m-pardhiv/SeaMesh/firmware/seamesh_mesh/seamesh_mesh.ino

// SeaMesh mesh node - ESP32 + Ra-02 (SX1278, 433 MHz)
//
// The same firmware runs on every boat. Only the settings block changes.
//  - Boat WITHOUT signal: broadcasts its own position/SOS and relays others.
//  - Boat WITH signal (joined to the phone hotspot = "cellular"): uploads
//    every packet it hears to the dashboard and ACKs SOS messages.
//    The React dashboard reads it as JSON from http://<gateway IP>/data
//
// Packet (text, ~45 bytes):
//   type,origin,msgId,lat,lon,time,hop,trigger,via
//   type: P = position, S = SOS, A = ack     via = last boat that transmitted it
//
// Serial commands (115200): sos, cancel, pos, offline, online, status

#include <SPI.h>
#include <LoRa.h>
#include <WiFi.h>
#include <WebServer.h>

// ================= Per-boat settings =================
#define BOAT_ID   "A"          // A, B, C ... (letters/numbers only)
#define WIFI_SSID ""           // phone hotspot = this boat's "cellular". "" = no signal
#define WIFI_PASS ""
#define BASE_LAT  0            // simulated GPS start position; 0 = pick a sea
#define BASE_LON  0            // position off Kochi from BOAT_ID (see initPosition)
// =====================================================

// Radio - minimum power, because there is no antenna
#define FREQ      433E6
#define TX_POWER  2
#define SYNC_WORD 0x5E
#define MAX_HOPS  4

// Ra-02 -> ESP32 wiring
#define PIN_SS   5
#define PIN_RST  14
#define PIN_DIO0 26
#define PIN_SCK  18
#define PIN_MISO 19
#define PIN_MOSI 23

// Sensors are optional: with nothing wired, both pins are held HIGH by the
// internal pull-ups and read as "no emergency". A missing sensor is never a fault.
#define PIN_SOS_BTN 27         // push button to GND
#define PIN_WATER   33         // bare wire; second bare wire to GND. Water bridging
                               // them pulls the pin LOW (use salty water for the demo)
#define WATER_WET_MS 2000      // must stay wet this long before it counts
#define LED_PIN     2

#define POS_INTERVAL    20000  // routine position update
#define SOS_INTERVAL    4000   // SOS repeat
#define SOS_MAX_REPEATS 15

struct Packet {
  char type;
  String origin;
  uint16_t msgId;
  float lat, lon;
  uint32_t t;
  uint8_t hop;
  String trig;
  String via;
};

// ---------- state ----------
uint16_t nextMsgId = 1;
float curLat, curLon;
unsigned long lastPos = 0;
bool forceOffline = false;
bool serverStarted = false;

bool sosActive = false;
String sosTrig = "";
int sosRepeats = 0;
unsigned long lastSos = 0;

unsigned long wetSince = 0;
bool lastBtn = HIGH;

// duplicate filter
#define SEEN_SIZE 40
String seen[SEEN_SIZE];
int seenPos = 0;

// relay queue
#define QUEUE_SIZE 6
struct Queued { bool used; Packet p; unsigned long due; };
Queued queue[QUEUE_SIZE];

// dashboard (only used when this boat is online)
#define TRAIL_LEN 10
struct BoatInfo {
  String id; float lat, lon; char type; int hops; String via;
  uint16_t msgId; unsigned long seenAt; int rssi; String trig;
  float trailLat[TRAIL_LEN], trailLon[TRAIL_LEN]; int trailCount;
};
#define MAX_BOATS 8
BoatInfo boats[MAX_BOATS];
int boatCount = 0;
#define MAX_EVENTS 12
String events[MAX_EVENTS];
int eventCount = 0;

WebServer server(80);

// ---------- helpers ----------
void blink() {
  digitalWrite(LED_PIN, HIGH);
  delay(30);
  digitalWrite(LED_PIN, sosActive ? HIGH : LOW);
}

bool online() {
  return strlen(WIFI_SSID) > 0 && !forceOffline && WiFi.status() == WL_CONNECTED;
}

uint32_t uptimeSec() { return millis() / 1000; }

bool isSafeField(const String& s) {
  if (s.length() == 0 || s.length() > 8) return false;
  for (unsigned int i = 0; i < s.length(); i++) {
    if (!isAlphaNumeric(s[i]) && s[i] != '-') return false;
  }
  return true;
}

String encode(const Packet& p) {
  return String(p.type) + "," + p.origin + "," + String(p.msgId) + "," +
         String(p.lat, 5) + "," + String(p.lon, 5) + "," + String(p.t) + "," +
         String(p.hop) + "," + p.trig + "," + p.via;
}

bool decode(const String& s, Packet& p) {
  String f[9];
  int idx = 0, start = 0;
  for (unsigned int i = 0; i <= s.length() && idx < 9; i++) {
    if (i == s.length() || s[i] == ',') {
      f[idx++] = s.substring(start, i);
      start = i + 1;
    }
  }
  if (idx != 9 || f[0].length() != 1) return false;
  p.type = f[0][0];
  if (p.type != 'P' && p.type != 'S' && p.type != 'A') return false;
  if (!isSafeField(f[1]) || !isSafeField(f[7]) || !isSafeField(f[8])) return false;
  p.origin = f[1];
  p.msgId = f[2].toInt();
  p.lat = f[3].toFloat();
  p.lon = f[4].toFloat();
  p.t = f[5].toInt();
  p.hop = f[6].toInt();
  p.trig = f[7];
  p.via = f[8];
  return true;
}

String keyOf(const Packet& p) {
  return String(p.type) + p.origin + ":" + String(p.msgId);
}

bool alreadySeen(const String& key) {
  for (int i = 0; i < SEEN_SIZE; i++) if (seen[i] == key) return true;
  return false;
}

void remember(const String& key) {
  seen[seenPos] = key;
  seenPos = (seenPos + 1) % SEEN_SIZE;
}

void addEvent(const String& e) {
  String line = String(uptimeSec()) + "s  " + e;
  Serial.println("EVENT " + line);
  if (eventCount < MAX_EVENTS) {
    events[eventCount++] = line;
  } else {
    for (int i = 1; i < MAX_EVENTS; i++) events[i - 1] = events[i];
    events[MAX_EVENTS - 1] = line;
  }
}

// ---------- radio ----------
byte readChipVersion() {
  pinMode(PIN_RST, OUTPUT);
  digitalWrite(PIN_RST, LOW);
  delay(10);
  digitalWrite(PIN_RST, HIGH);
  delay(10);
  pinMode(PIN_SS, OUTPUT);
  digitalWrite(PIN_SS, HIGH);
  SPI.beginTransaction(SPISettings(1000000, MSBFIRST, SPI_MODE0));
  digitalWrite(PIN_SS, LOW);
  SPI.transfer(0x42 & 0x7F);
  byte v = SPI.transfer(0x00);
  digitalWrite(PIN_SS, HIGH);
  SPI.endTransaction();
  return v;
}

void transmit(Packet p) {
  p.via = BOAT_ID;
  String s = encode(p);
  LoRa.beginPacket();
  LoRa.print(s);
  LoRa.endPacket();
  Serial.println("TX    " + s);
  blink();
}

void enqueue(const Packet& p) {
  // SOS and ACKs go out almost immediately, routine updates wait a little
  // (random jitter so two relays don't transmit on top of each other)
  unsigned long delayMs = (p.type == 'P') ? random(200, 800) : random(20, 80);
  for (int i = 0; i < QUEUE_SIZE; i++) {
    if (!queue[i].used) {
      queue[i] = { true, p, millis() + delayMs };
      return;
    }
  }
  Serial.println("WARN  relay queue full, dropped " + keyOf(p));
}

void processQueue() {
  int pick = -1;
  for (int i = 0; i < QUEUE_SIZE; i++) {
    if (!queue[i].used || millis() < queue[i].due) continue;
    if (pick < 0 || (queue[i].p.type != 'P' && queue[pick].p.type == 'P')) pick = i;
  }
  if (pick >= 0) {
    queue[pick].used = false;
    transmit(queue[pick].p);
  }
}

// ---------- dashboard ----------
// The dashboard keeps the last packet heard from every boat, so a boat that
// goes silent stays on the map at its last known position.
void upload(const Packet& p, int rssi) {
  int i = 0;
  while (i < boatCount && boats[i].id != p.origin) i++;
  if (i == boatCount) {
    if (boatCount == MAX_BOATS) return;
    boats[i] = BoatInfo();
    boats[i].id = p.origin;
    boats[i].type = 'P';
    boatCount++;
  }
  BoatInfo& b = boats[i];

  // an SOS stays on the map as SOS until that boat's SOS is over
  bool sosSticky = p.type == 'P' && b.type == 'S' && millis() - b.seenAt < 60000;
  b.type = sosSticky ? 'S' : p.type;
  if (!sosSticky) b.trig = p.trig;
  b.lat = p.lat;
  b.lon = p.lon;
  b.hops = p.hop;
  b.via = p.via;
  b.msgId = p.msgId;
  b.seenAt = millis();
  b.rssi = rssi;

  if (b.trailCount == TRAIL_LEN) {
    for (int k = 1; k < TRAIL_LEN; k++) {
      b.trailLat[k - 1] = b.trailLat[k];
      b.trailLon[k - 1] = b.trailLon[k];
    }
    b.trailCount--;
  }
  b.trailLat[b.trailCount] = p.lat;
  b.trailLon[b.trailCount] = p.lon;
  b.trailCount++;

  String how = (p.origin == BOAT_ID) ? "own position"
             : (p.hop == 0 ? "direct" : String(p.hop) + " relay hop(s), last via " + p.via);
  addEvent(String(p.type == 'S' ? "SOS" : "Position") + " from boat " + p.origin +
           " (" + how + ")" + (rssi != 0 ? ", RSSI " + String(rssi) : ""));
}

#define STALE_SEC 60   // no contact for this long = shown as "last known"

// JSON API for the React dashboard (CORS open so it can run on any origin)
void handleData() {
  server.sendHeader("Access-Control-Allow-Origin", "*");
  server.sendHeader("Cache-Control", "no-store");
  String j = "{\"gw\":\"" BOAT_ID "\",\"online\":" + String(online() ? "true" : "false") +
             ",\"uptime\":" + String(uptimeSec()) + ",\"boats\":[";
  for (int i = 0; i < boatCount; i++) {
    BoatInfo& b = boats[i];
    unsigned long age = (millis() - b.seenAt) / 1000;
    if (i) j += ",";
    j += "{\"id\":\"" + b.id + "\",\"lat\":" + String(b.lat, 5) + ",\"lon\":" + String(b.lon, 5) +
         ",\"type\":\"" + String(b.type) + "\",\"hops\":" + String(b.hops) + ",\"via\":\"" + b.via +
         "\",\"msg\":" + String(b.msgId) + ",\"age\":" + String(age) +
         ",\"stale\":" + String(age > STALE_SEC ? "true" : "false") +
         ",\"rssi\":" + String(b.rssi) + ",\"trig\":\"" + b.trig + "\",\"trail\":[";
    for (int k = 0; k < b.trailCount; k++) {
      if (k) j += ",";
      j += "[" + String(b.trailLat[k], 5) + "," + String(b.trailLon[k], 5) + "]";
    }
    j += "]}";
  }
  j += "],\"events\":[";
  for (int i = 0; i < eventCount; i++) {
    if (i) j += ",";
    j += "\"" + events[i] + "\"";
  }
  j += "]}";
  server.send(200, "application/json", j);
}

// ---------- own messages ----------
// Simulated GPS: every boat starts out at sea off Kochi, inside or outside
// the ~20 km cellular coverage around Kochi.
void initPosition() {
  if (BASE_LAT != 0) { curLat = BASE_LAT; curLon = BASE_LON; return; }
  switch (BOAT_ID[0]) {
    case 'A': curLat = 9.9500; curLon = 75.9500; break;   // ~32 km out, no signal
    case 'B': curLat = 9.9800; curLon = 76.1400; break;   // ~12 km out, in coverage
    case 'C': curLat = 9.9650; curLon = 76.0400; break;   // ~24 km out, between them
    default:  curLat = 9.9200 + random(0, 600) / 10000.0;
              curLon = 75.9800 + random(0, 1000) / 10000.0; break;
  }
}

Packet makeOwn(char type, const String& trig) {
  Packet p;
  p.type = type;
  p.origin = BOAT_ID;
  p.msgId = nextMsgId++;
  p.lat = curLat;
  p.lon = curLon;
  p.t = uptimeSec();
  p.hop = 0;
  p.trig = trig;
  p.via = BOAT_ID;
  return p;
}

void sendOwn(const Packet& p) {
  remember(keyOf(p));
  if (online()) {
    upload(p, 0);          // we have signal ourselves - straight to the dashboard
    if (p.type == 'S') sosActive = false;
  } else {
    transmit(p);
  }
}

// Each repeat is a new message id, so a repeat that follows a lost packet
// or a lost ACK is relayed and ACKed again instead of dropped as a duplicate.
void sendSos() {
  sosRepeats++;
  lastSos = millis();
  Serial.println("SOS   attempt " + String(sosRepeats) + "/" + String(SOS_MAX_REPEATS));
  sendOwn(makeOwn('S', sosTrig));
}

void triggerSos(const String& trig) {
  if (sosActive) return;
  sosActive = true;
  sosTrig = trig;
  sosRepeats = 0;
  digitalWrite(LED_PIN, HIGH);
  Serial.println("!!!   SOS triggered by " + trig);
  sendSos();
}

void cancelSos(const String& why) {
  if (!sosActive) return;
  sosActive = false;
  digitalWrite(LED_PIN, LOW);
  Serial.println("SOS   stopped: " + why);
}

// ---------- incoming ----------
void onPacket(Packet p, int rssi) {
  String key = keyOf(p);
  if (alreadySeen(key)) {
    Serial.println("DUP   " + key + " dropped");
    return;
  }
  remember(key);
  Serial.println("RX    " + encode(p) + "  RSSI " + String(rssi));

  // ACK for one of our own SOS messages
  if (p.type == 'A' && p.origin == BOAT_ID) {
    if (sosActive) cancelSos("ACK from shore via boat " + p.via + " - SOS delivered!");
    return;
  }
  if (p.origin == BOAT_ID) return;   // our own packet echoed back by a relay

  if (online() && p.type != 'A') {
    upload(p, rssi);
    if (p.type == 'S') {
      Packet ack = p;
      ack.type = 'A';
      ack.hop = 0;
      ack.trig = "ACK";
      remember(keyOf(ack));
      enqueue(ack);
    }
    return;
  }

  if (p.hop + 1 >= MAX_HOPS) {
    Serial.println("DROP  " + key + " hop limit reached");
    return;
  }
  p.hop++;
  Serial.println("RELAY " + key + " (hop " + String(p.hop) + ")");
  enqueue(p);
}

// ---------- inputs ----------
void checkInputs() {
  bool btn = digitalRead(PIN_SOS_BTN);
  if (btn == LOW && lastBtn == HIGH) {
    delay(30);
    if (digitalRead(PIN_SOS_BTN) == LOW) triggerSos("BTN");
  }
  lastBtn = btn;

  if (digitalRead(PIN_WATER) == LOW) {
    if (wetSince == 0) wetSince = millis();
    else if (millis() - wetSince > WATER_WET_MS) triggerSos("WATER");
  } else {
    wetSince = 0;
  }

  if (Serial.available()) {
    String cmd = Serial.readStringUntil('\n');
    cmd.trim();
    if (cmd == "sos") triggerSos("BTN");
    else if (cmd == "cancel") cancelSos("cancelled by user");
    else if (cmd == "pos") sendOwn(makeOwn('P', "-"));
    else if (cmd == "offline") { forceOffline = true; Serial.println("MODE  forced offline (no cellular)"); }
    else if (cmd == "online") { forceOffline = false; Serial.println("MODE  online allowed"); }
    else if (cmd == "status") {
      Serial.println("STAT  boat " BOAT_ID ", " + String(online() ? "ONLINE (gateway)" : "OFFLINE (relay)") +
                     ", SOS " + String(sosActive ? "active" : "off") +
                     (WiFi.status() == WL_CONNECTED ? ", IP " + WiFi.localIP().toString() : ""));
    }
  }
}

void setup() {
  Serial.begin(115200);
  delay(1000);
  pinMode(LED_PIN, OUTPUT);
  pinMode(PIN_SOS_BTN, INPUT_PULLUP);
  pinMode(PIN_WATER, INPUT_PULLUP);
  randomSeed(esp_random());
  initPosition();

  Serial.println();
  Serial.println("=== SeaMesh node " BOAT_ID " ===");

  SPI.begin(PIN_SCK, PIN_MISO, PIN_MOSI, PIN_SS);
  byte v = readChipVersion();
  Serial.println("Chip version: 0x" + String(v, HEX));
  if (v != 0x12) {
    Serial.println("[FAIL] Ra-02 not found - check wiring");
    while (1) { digitalWrite(LED_PIN, !digitalRead(LED_PIN)); delay(150); }
  }
  LoRa.setPins(PIN_SS, PIN_RST, PIN_DIO0);
  if (!LoRa.begin(FREQ)) {
    Serial.println("[FAIL] LoRa.begin() failed");
    while (1) { digitalWrite(LED_PIN, !digitalRead(LED_PIN)); delay(150); }
  }
  LoRa.setTxPower(TX_POWER);
  LoRa.setSyncWord(SYNC_WORD);
  LoRa.enableCrc();
  Serial.println("[OK] LoRa 433 MHz, TX power " + String(TX_POWER) + " dBm (no antenna mode)");

  Serial.println("[OK] Sensors optional: SOS button D27, water D33 (nothing wired = no alert)");

  if (strlen(WIFI_SSID) > 0) {
    WiFi.mode(WIFI_STA);
    WiFi.setAutoReconnect(true);
    WiFi.begin(WIFI_SSID, WIFI_PASS);
    Serial.println("[..] Joining hotspot '" WIFI_SSID "' (this boat's cellular link)");
  } else {
    WiFi.mode(WIFI_OFF);
    Serial.println("[--] No hotspot set - this boat has no signal, will relay over LoRa");
  }

  server.on("/", []() {
    server.sendHeader("Access-Control-Allow-Origin", "*");
    server.send(200, "application/json", "{\"service\":\"SeaMesh gateway\",\"boat\":\"" BOAT_ID "\",\"data\":\"/data\"}");
  });
  server.on("/data", handleData);
  Serial.println("Commands: sos, cancel, pos, offline, online, status");
  Serial.println("--------------------------");
}

void loop() {
  // start the dashboard once the hotspot connection is up
  if (!serverStarted && WiFi.status() == WL_CONNECTED) {
    server.begin();
    serverStarted = true;
    Serial.println("[OK] Online - dashboard data at http://" + WiFi.localIP().toString() + "/data");
    addEvent("Gateway boat " BOAT_ID " online");
  }
  if (serverStarted) server.handleClient();

  int size = LoRa.parsePacket();
  if (size) {
    String s;
    while (LoRa.available()) s += (char)LoRa.read();
    Packet p;
    if (decode(s, p)) onPacket(p, LoRa.packetRssi());
    else Serial.println("BAD   ignored: " + s);
    blink();
  }

  checkInputs();
  processQueue();

  if (sosActive && millis() - lastSos > SOS_INTERVAL) {
    if (sosRepeats >= SOS_MAX_REPEATS) cancelSos("no ACK after " + String(SOS_MAX_REPEATS) + " tries");
    else sendSos();
  }

  if (!sosActive && millis() - lastPos > POS_INTERVAL) {
    lastPos = millis();
    curLat += random(-20, 21) / 100000.0;   // simulated drift
    curLon += random(-20, 21) / 100000.0;
    sendOwn(makeOwn('P', "-"));
  }
}
