m-pardhiv/SeaMesh/(commit log)

2026-10-23 Add SeaMesh LoRa mesh firmware and README
    ESP32 + Ra-02 (SX1278, 433 MHz) firmware for boat-to-boat position and
    SOS relay: duplicate filtering, hop limit, SOS priority and repeats,
    ACK back to the sender, and a Leaflet map dashboard on the gateway boat.
2026-10-23 Show boats at sea and their last known position on the dashboard
    Each boat gets a simulated start position off Kochi from its ID. Boats
    not heard for 60 s turn grey and are labelled LAST KNOWN with the time
    since contact; the map also shows position trails, an approximate
    cellular coverage circle, and zooms to fit all boats. The dashboard page
    moves to dashboard.h because the Arduino preprocessor misparsed it
    inside the .ino.
2026-10-23 Make sensors optional and switch the water sensor to conductivity
    Only one demo unit has sensors. Both inputs now use internal pull-ups,
    so a unit with nothing wired reads "no emergency" and never raises an
    alert or fault. The water sensor moves from touch sensing on D4 (which
    could fire when the wires were handled) to a conductivity check on D33
    that must stay wet for 2 s.
2026-10-23 Move to phone-over-Bluetooth firmware and the new repo layout
    The firmware is now identical on every board: the boat ID comes from the
    chip MAC, and the boat's GPS and internet link is the SeaMesh phone app
    over BLE instead of a WiFi hotspot. A boat whose phone reports internet
    hands packets to the phone for upload and sends the LoRa ACK only after
    the phone confirms the upload. The on-board JSON API is gone; the
    dashboard will get data from the backend.
    The sketch moves to esp32_firmware/ and the README describes the new
    flow, the BLE contract and the folder layout.
2026-10-23 Add the backend: phone uploads in, live WebSocket updates out
    Node.js server for Render. Phones POST packets to /api/alerts with an
    API key; the server keeps the latest state of every boat in memory,
    drops duplicate uploads from multiple gateways, keeps an SOS active for
    10 minutes after its last SOS packet, and pushes each change to
    dashboards over the /live WebSocket. GET /api/boats serves the current
    state, /api/reset clears it between demo runs.
    simulate.js plays a two-boat SOS scenario against any deployment, so
    the dashboard can be tested without boards or phones.
2026-10-23 Fix app build and duplicate-message bugs found in review
    App: drop the AI Studio-only debug signing config so the APK builds
    locally and in CI, refresh the permission banner after permissions are
    granted, and remove the dataSync foreground service type, which
    Android 15 stops after 6 hours.
    Firmware: start message ids at a random value on boot, because the app
    and backend drop repeated boat+msgId pairs as duplicates and ids
    restarting at 1 after a reboot would never reach the dashboard. Only
    an upload ACK for one of the current SOS packets ends the SOS, not a
    late ACK for an earlier position packet.
2026-10-23 Build the Android APK on GitHub Actions
    On every push that changes the app (or a manual run), build the debug
    APK with Gradle 9.3.1, attach it to the run, and publish it on main as
    the apk-latest release so phones can download it directly.
2026-10-23 Fix the APK build: use the runner's Android SDK on Ubuntu 24.04
    The setup-android action failed on the runner, so the build never
    started. Pin the job to ubuntu-24.04, whose image ships the Android
    SDK, accept its licenses directly, and drop the action. Also move
    checkout and setup-java to v5, which GitHub flagged as deprecated.
2026-10-23 Keep the node running without the Ra-02 and restart it if it freezes
    A loose Ra-02 wire made the radio missing at boot, and the firmware
    stopped there before starting Bluetooth, so the phone app showed
    "Not found" and the board ignored commands. The node now starts
    without the radio, keeps Bluetooth and phone uploads working, and
    retries the radio every 10 s; a radio that disappears during a send is
    retried the same way.
    A task watchdog restarts the board if loop() stops for 8 s, and the
    boot log prints the last restart reason. status also reports the radio
    state, uptime and free heap. New serial commands: txtest to trace one
    LoRa transmission and hangtest to check the watchdog.
2026-10-23 Make LoRa sends reliable with a noisy Ra-02 link and guard the settings
    Without an antenna on a breadboard, SPI reads during transmission come
    back corrupted, so waiting for TX done by polling the IRQ register
    often never saw it. Map TX done to DIO0 and wait on that pin instead,
    and run SPI at 1 MHz instead of 8 for the long jumper wires: 11 of 11
    test packets were sent.
    SPI writes were also landing in the wrong registers (bandwidth read
    back as 10 kHz instead of 125 kHz), which would leave two nodes unable
    to hear each other. The key modem settings are now checked before every
    send and every 3 s and re-applied when they differ. New serial command
    regs dumps the modem registers.
2026-10-23 Get the boat-to-boat SOS working: SF9, 10 dBm and a packet checksum
    With no antennas, 2 dBm at SF7 never reached the other board even at
    30 cm (received signal at the noise floor). Raise TX power to 10 dBm,
    the license-free limit at 433 MHz in India, and use spreading factor 9
    for about 6 dB more sensitivity; a 51-byte packet now takes ~0.33 s.
    Packets also arrived corrupted after the LoRa CRC passed ("B908" read
    as "B9r8"), from SPI errors while reading the FIFO, and garbled ACKs
    were relayed back and forth as packets from other boats. Every packet
    on the air now ends in "*XX", a CRC-8 of the text checked after the
    read; bad packets are dropped.
    Result on two boards: 7 of 7 SOS packets fr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
2026-10-23 Remove the Kochi harbour reference from the dashboard
    The harbour marker and every "km DIR of Kochi harbour" line (SOS
    banner, boat cards, map popup, notification text) were based on a
    hard-coded point and added nothing real. The map now fits to the boats
    alone. The unused haversine and bearing helpers go with it.
2026-10-23 Catch every SOS button press: interrupt-driven detection with logging
    The button hardware is fine (28 test presses, almost all clean), but
    presses were being missed in firmware: the old code only looked at the
    pin once per loop and then required it to still be LOW 30 ms later, while
    loop() is blocked for about 0.33 s on every LoRa send, longer than many
    quick taps. An interrupt now records when the pin goes LOW and HIGH, and
    loop() accepts a press once it has lasted 25 ms; shorter blips are
    logged as glitches. Presses made while an SOS is already being sent are
    logged as ignored instead of silently dropped.
    New serial command btntest records the raw pin for 20 s and reports each
    press with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
2026-10-23 Redesign the dashboard: dark glass layout, Outfit, green/cyan/orange palette
    New layout modelled on the team's reference design: a header with pill
    tabs that jump to Map, Boats and Events, round status buttons and the
    clock; a large "Dashboard" title with a search box that filters the boat
    list by ID (press / to focus it); and a card grid with the map in the
    centre, the boat list below it and the event log on the right.
    Two new cards use data the dashboard already had: a fleet card (live,
    last known, active SOS, how many boats reach shore through the mesh, and
    the sound/notification button) and a boarding-pass style card for the
    selected boat (or the newest SOS) showing boat, route and gate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
2026-10-23 Make SOS red, drop the map's bottom bar and fix the left-column scrollbar
    SOS now uses red (#FF3B3B) everywhere: banner, map markers and ring,
    badges, the boat ticket and boat list, the event log and the
    Acknowledge button. Connecting/reconnecting and configuration errors
    use amber so they don't read as emergencies.
    The ticket card's tear-line notches stuck out past the card edge and
    gave the left column a horizontal scrollbar; the card now clips them,
    and the column tightens on short screens so it fits without a vertical
    scrollbar either.
    The "boats reporting" bar along the bottom of the map is removed (the
    fleet card already shows the same counts), and the map auto-fit leaves
    more room o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
2026-10-23 Zoom the map to a boat as soon as it raises an SOS
    When a new SOS incident appears (including when the page is opened
    during one), the map flies to the boat at zoom 13 and opens its popup,
    and the boat card switches to it. While an SOS is active the map no
    longer snaps back to the whole fleet when another boat reports for the
    first time. Once every SOS is cleared (Acknowledge, or the server
    expiring it) the view returns to the whole fleet and the selection is
    dropped.
